ojonav/AM3703-DM3730TorpedoSOM-TestBoard/(list of files, drawings)

Other design files:
PCB LIBRARY_Ojonav/CAP_CER_0402_KEMET.PcbLib
PCB LIBRARY_Ojonav/CAP_CER_0603_KEMET.PcbLib
PCB LIBRARY_Ojonav/CAP_CER_0805_KEMET.PcbLib
PCB LIBRARY_Ojonav/Chip2PinSM127P600-8N_FerriteBead_TDK.PcbLib
PCB LIBRARY_Ojonav/FIDUCIAL_1MM.PcbLib
PCB LIBRARY_Ojonav/LEDCP1006X02N_PICOLED_0402.PcbLib
PCB LIBRARY_Ojonav/MTGHOLE-156_P.PcbLib
PCB LIBRARY_Ojonav/MTGHOLE.PcbLib
PCB LIBRARY_Ojonav/PcbLib1.PcbLib
PCB LIBRARY_Ojonav/QFN127P600-8N_FTDI_20PIN.PcbLib
PCB LIBRARY_Ojonav/RES_CHIP_0402.PcbLib
PCB LIBRARY_Ojonav/RES_CHIP_0603.PcbLib
PCB LIBRARY_Ojonav/RES_CHIP_0805.PcbLib
PCB LIBRARY_Ojonav/SD_CARD_KYOCERA_145638009511859+.PcbLib
PCB LIBRARY_Ojonav/SD_CARD_Micro_Hirose.PcbLib
PCB LIBRARY_Ojonav/SDCard_MicroConn_Hirose_DM3ATSFPEJM5.PcbLib
PCB LIBRARY_Ojonav/SOM.PcbLib
PCB LIBRARY_Ojonav/SOP127P600-8N_100PinConnRecptr_Hirose.PcbLib
PCB LIBRARY_Ojonav/SOP127P600-8N_100PinConnRecptr_Hirose_1.PcbLib
PCB LIBRARY_Ojonav/SOP127P600-8N_Connector_100PIN_Hirose.PcbLib
PCB LIBRARY_Ojonav/SOP127P600-8N_Header_10PIN_Harwin.PcbLib
PCB LIBRARY_Ojonav/SOP127P600-8N_PushButtonRacon8.PcbLib
PCB LIBRARY_Ojonav/SOP127P600-8N_PushButtonSwitch_CnK.PcbLib
PCB LIBRARY_Ojonav/SOP127P800X250-16N_DIP_SWITCH_COPAL.PcbLib
PCB LIBRARY_Ojonav/TorpedoSOM_SOP127P600-8N_ConnectorsCoupld_100PIN_Hirose.PcbLib
PCB LIBRARY_Ojonav/USBConn_Assman_AuY1006R.PcbLib
Schematic Library/Cap.Schlib
Schematic Library/Fiducial-1mm.SchLib
Schematic Library/RES.Schlib
Schematic Library/SchlibOjonav.SchLib
Schematic Library/SD_CARD_KYOCERA.SchLib
Schematic Library/SD_Card_Micro.SchLib
Schematics/Fiducials.SchDoc
Schematics/GPIO_Connector.SchDoc
Schematics/IO_Connectors.SchDoc
Schematics/Onboard_LEDs.SchDoc
Schematics/SD_CARD.SchDoc
Schematics/SOM_Resets_BootConfig.SchDoc
Schematics/Title_Page.SchDoc
Schematics/TOP_LEVEL.SchDoc
Schematics/TorpedoSOM_Receptor_J2.SchDoc
Schematics/TorpedoSOM_ReceptorS.SchDoc
Schematics/USB_UART_Convertors.SchDoc
TorpedoSOMDevBoard_v1.1.PcbDoc
TorpedoSOMDevBoard_v1.2.PcbDoc
TorpedoSOMDevBoard_v1.3.PcbDoc
