ojonav/AM3703-DM3730TorpedoSOM-TestBoard/(commit log)

2012-07-05 TorpedoSOM Design Files
    1. Design Requirements version 1.1
    2. Schematics & BOM(in .pdf)
    3. PCB file version 1.1
    [TorpedoSOMDevBoard_v1.1.PcbDoc]
2012-07-05 PCB doc updated
    USB Connector Heights added
    [TorpedoSOMDevBoard_v1.2.PcbDoc]
2012-09-18 Version 1.3 added
    [TorpedoSOMDevBoard_v1.3.PcbDoc]
2012-09-18 Schematics Added
    [Cap.Schlib, Fiducial-1mm.SchLib, Fiducials.SchDoc, GPIO_Connector.SchDoc, IO_Connectors.SchDoc, Onboard_LEDs.SchDoc, RES.Schlib, SD_CARD.SchDoc]
2012-09-18 PCB Library Added
    [CAP_CER_0402_KEMET.PcbLib, CAP_CER_0603_KEMET.PcbLib, CAP_CER_0805_KEMET.PcbLib, Chip2PinSM127P600-8N_FerriteBead_TDK.PcbLib, FIDUCIAL_1MM.PcbLib, LEDCP1006X02N_PICOLED_0402.PcbLib, MTGHOLE-156_P.PcbLib, MTGHOLE.PcbLib]
